OlsonJM/MODBUS-Data-Logger/Component Documents/Schematics & Layout/DoublerLayout.png

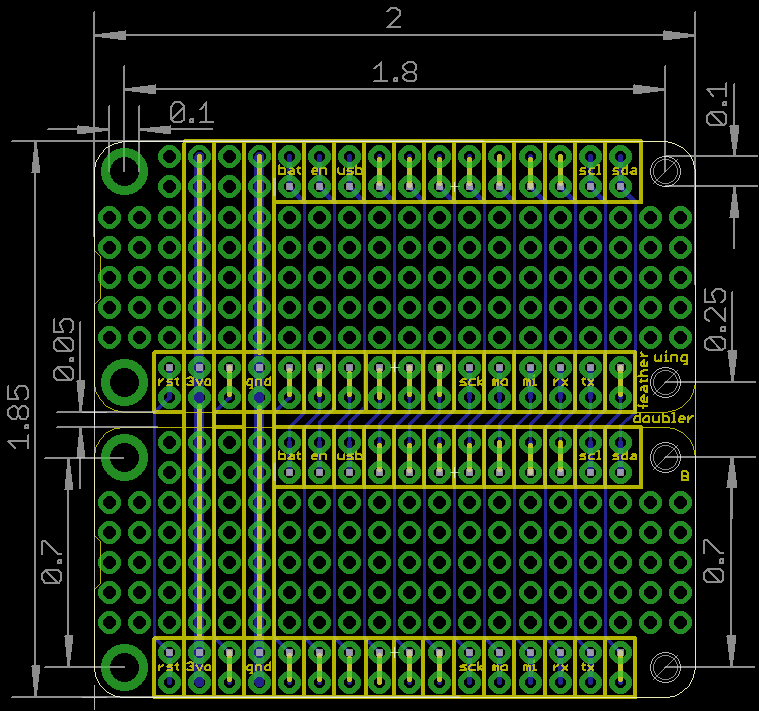
Component Documents/Schematics & Layout/DoublerLayout.png
