OlsonJM/MODBUS-Data-Logger/Component Documents/Schematics & Layout/FAB - FeatherEthernet.png

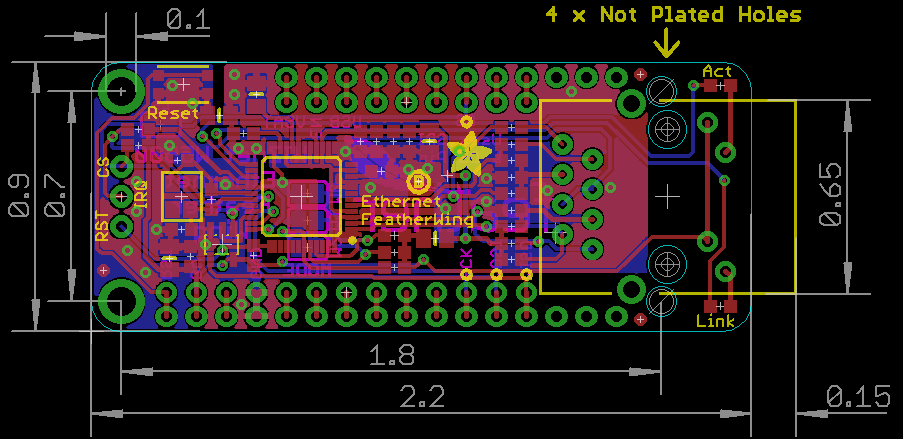
Component Documents/Schematics & Layout/FAB - FeatherEthernet.png
