OlsonJM/MODBUS-Data-Logger/Component Documents/Schematics & Layout/FAB - FeatherRTC.png

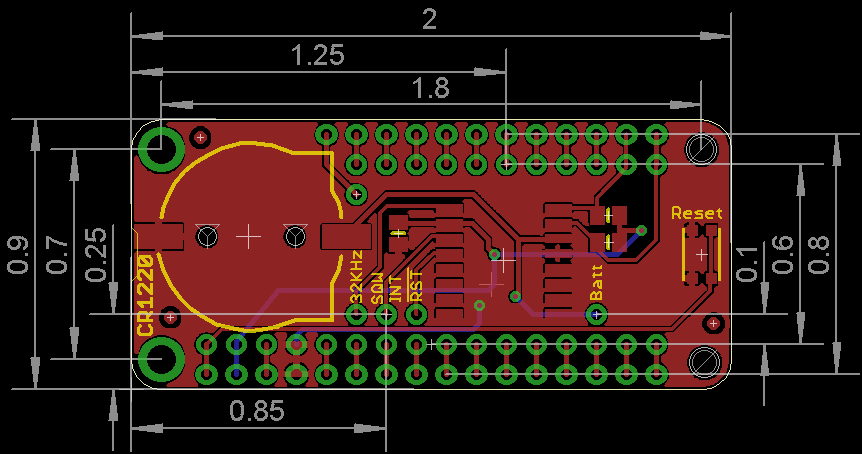
Component Documents/Schematics & Layout/FAB - FeatherRTC.png
