OlsonJM/MODBUS-Data-Logger/Component Documents/Schematics & Layout/SCH - FeatherOLED.png

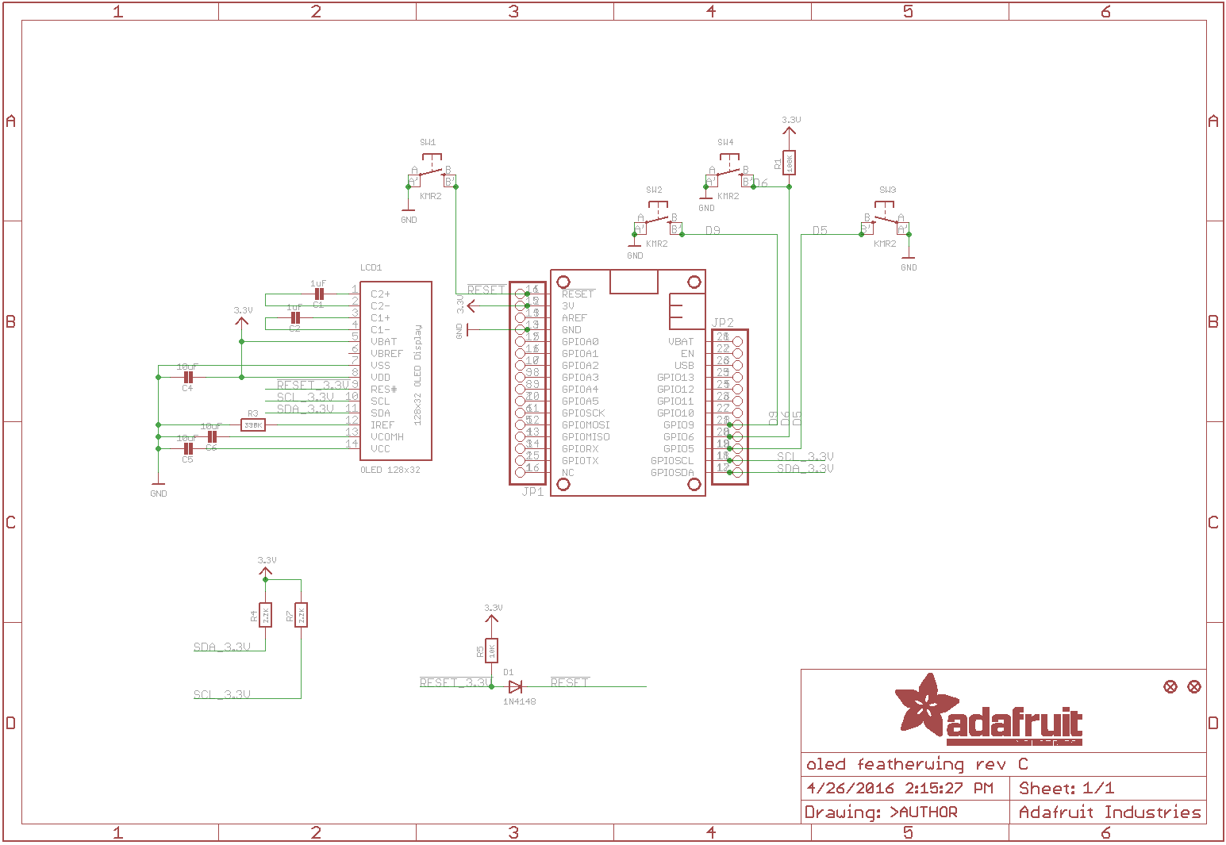
Component Documents/Schematics & Layout/SCH - FeatherOLED.png
