OlsonJM/MODBUS-Data-Logger/Proj Documents/T9 - ModLog Material Costs.xlsx

ModLog - Project Material Cost List
EE537 - Microcontroller Applications |  |  |  | Project Total | $113.72
Quantity | Cost | Part# | Supplier | Description | Link | Line Total
1 | $21.95 | 2796 | www.adafruit.com | Adafruit Feather M0 Adalogger | www.adafruit.com/products/2796 | $21.95
1 | $19.95 | 3201 | www.adafruit.com | Adafruit Feather Ethernet Wing | www.adafruit.com/products/3201 | $19.95
1 | $13.95 | 3028 | www.adafruit.com | Adafruit DS3231 Precision RTC | www.adafruit.com/products/3028 | $13.95
1 | $14.95 | 2900 | www.adafruit.com | Adafruit 128x32 OLED Display | www.adafruit.com/products/2900 | $14.95
1 | $5.95 | 1570 | www.adafruit.com | Lithium Ion 3.7V 500mAh Battery | www.adafruit.com/products/1570 | $5.95
1 | $7.50 | 2890 | www.adafruit.com | Adafruit Feather Doubler | www.adafruit.com/products/2890 | $7.50
1 | $12.62 | B0143YVNHW | www.amazon.com | Enclosure | www.amazon.com/gp/product/B0143YVNHW/ | $12.62
1 | $4.95 | 909 | www.adafruit.com | Ethernet Extender | www.adafruit.com/products/909 | $4.95
1 | $3.95 | 937 | www.adafruit.com | USB Extender | www.adafruit.com/products/937 | $3.95
1 | $1.50 | 1439 | www.adafruit.com | Pushbutton - RED LED | www.adafruit.com/products/1439 | $1.50
1 | $1.50 | 1440 | www.adafruit.com | Pushbutton -Green LED | www.adafruit.com/products/1440 | $1.50
1 | $4.95 | 2884 | www.adafruit.com | Feather Potor Board | www.adafruit.com/products/2884 | $4.95
