OlsonJM/MODBUS-Data-Logger/Component Documents/Component Specifications/BLOCK - MAXIM DS3231 RTC IC.png

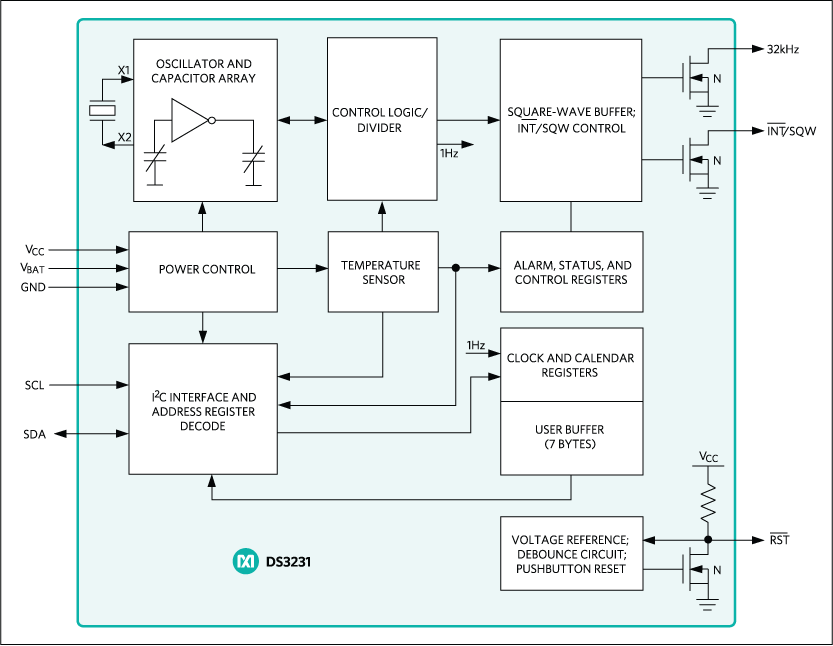
Component Documents/Component Specifications/BLOCK - MAXIM DS3231 RTC IC.png
