OlsonJM/MODBUS-Data-Logger/(list of files, cad)

Other CAD files:
Proj Documents/Protoboard Layout.dwg
